SimonBrenninger/FT4232H-Debugger/debugger_base/debugger_base.kicad_pcb

## KiCad design debugger_base/debugger_base.kicad_pcb (2025-02-14)

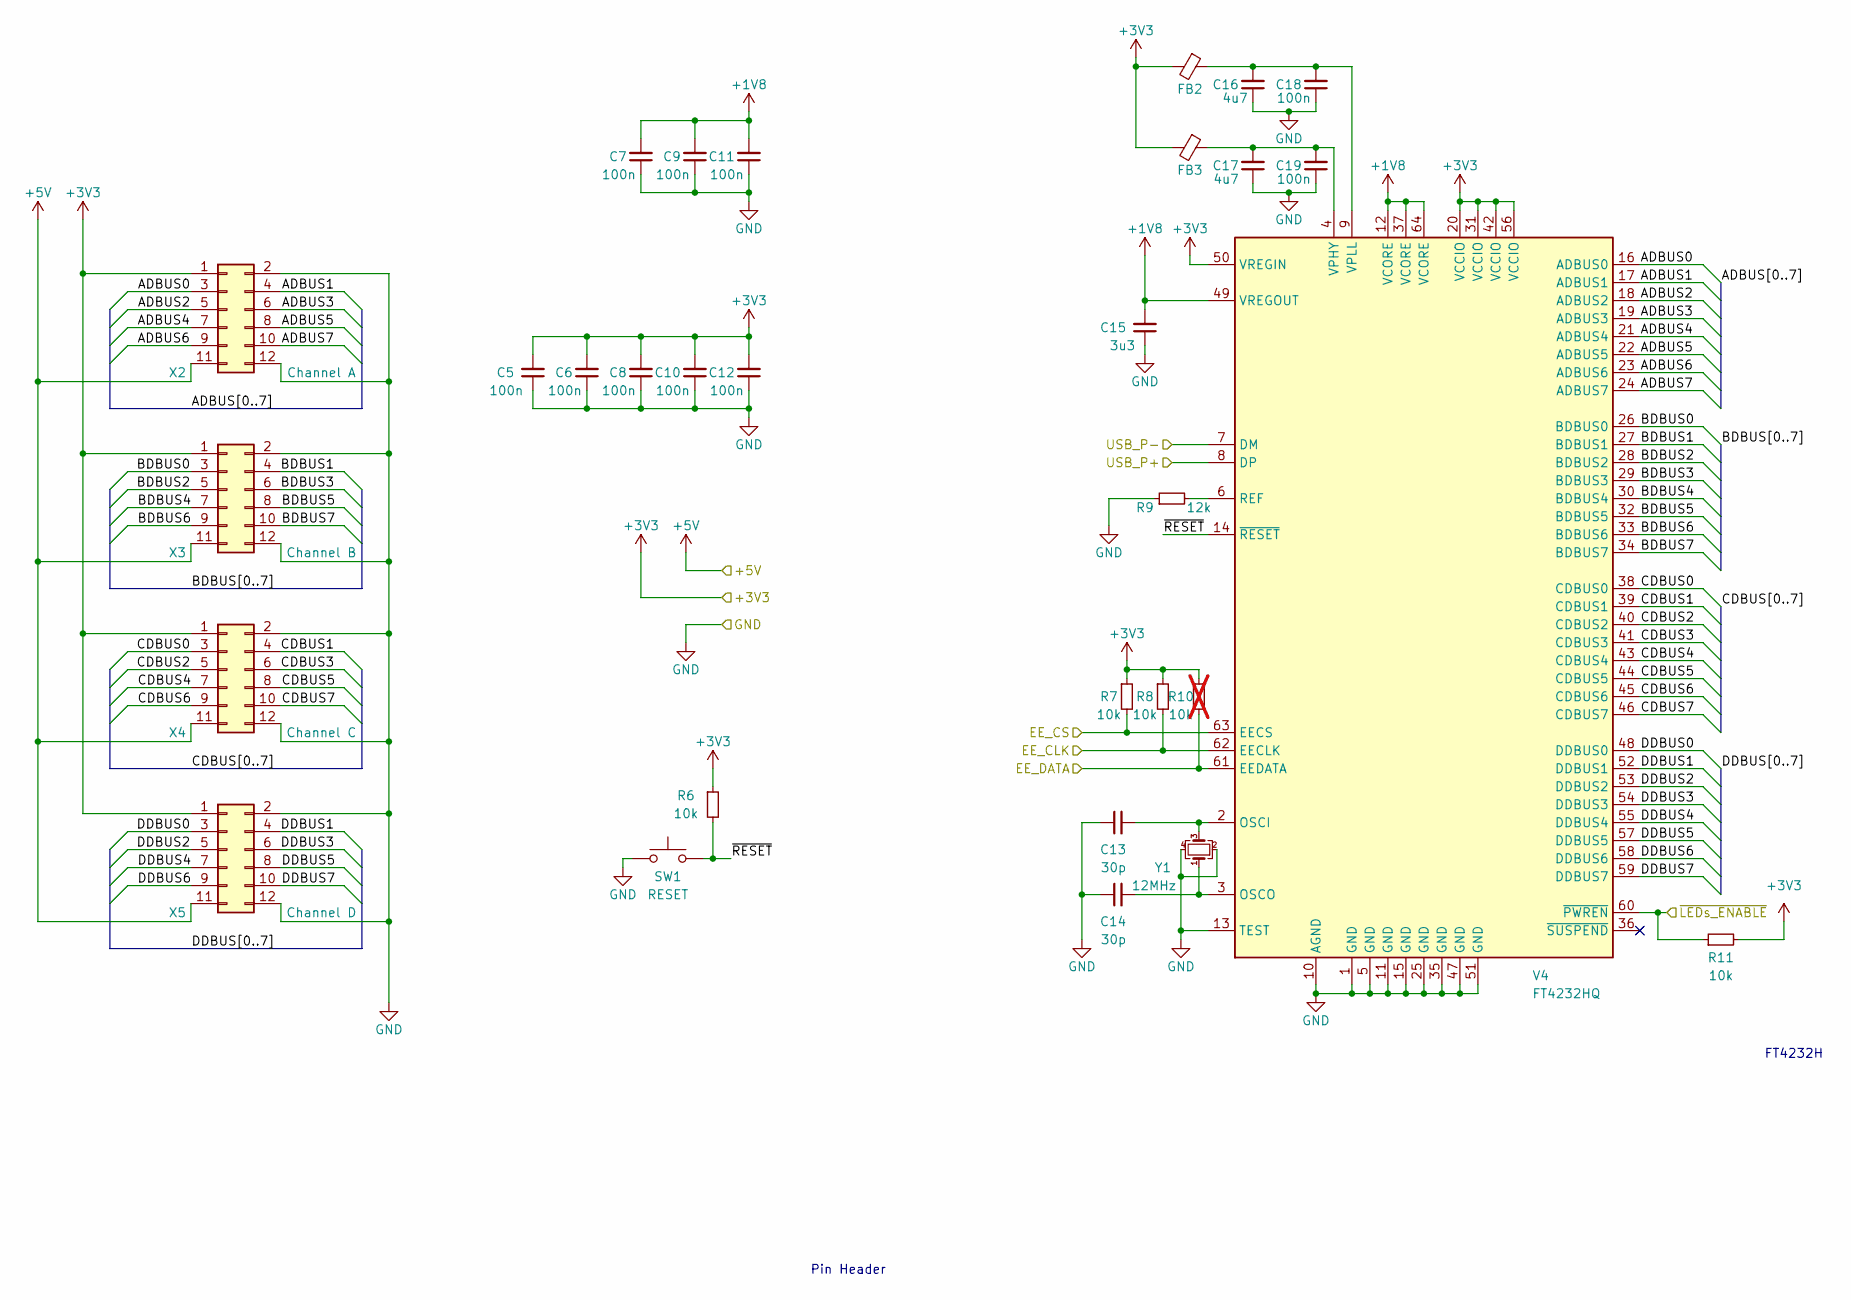
[picture p1: schematic debugger_base_ft4232h.kicad_sch, FT4232 Debugger Base]

Parts:
C5, C6, C7, C8, C9, C10, C11, C12, C18, C19: 100n; C_0402_1005Metric
C13, C14: 30p; C_0402_1005Metric
C15: 3u3; C_0402_1005Metric
C16, C17: 4u7; C_0402_1005Metric
FB2, FB3: FerriteBead_Small; L_0603_1608Metric
R6, R7, R8, R11: 10k; R_0402_1005Metric
R9: 12k; R_0402_1005Metric
R10: 10k; R_0402_1005Metric; not fitted
SW1: RESET; SW_SPST_EVQP2
V4: FT4232HQ; QFN-64-1EP_9x9mm_P0.5mm_EP4.35x4.35mm
X2: Channel A; header_female_02x06_613012243121
X3: Channel B; header_female_02x06_613012243121
X4: Channel C; header_female_02x06_613012243121
X5: Channel D; header_female_02x06_613012243121
Y1: 12MHz; Crystal_SMD_3225-4Pin_3.2x2.5mm

Connections:
+1V8: C7.2, C9.2, C11.2, C15.2, V4.12 (VCORE), V4.37 (VCORE), V4.49 (VREGOUT), V4.64 (VCORE)
+3V3: C5.2, C6.2, C8.2, C10.2, C12.2, FB2.2, FB3.2, R6.1, R7.1, R8.1, R10.1, R11.2, V4.20 (VCCIO), V4.31 (VCCIO), V4.42 (VCCIO), V4.50 (VREGIN), V4.56 (VCCIO), X2.1, X3.1, X4.1, X5.1; also elsewhere on the board
+5V: X2.11, X3.11, X4.11, X5.11; also elsewhere on the board
/FT4232H/ADBUS0: V4.16 (ADBUS0), X2.3
/FT4232H/ADBUS1: V4.17 (ADBUS1), X2.4
/FT4232H/ADBUS2: V4.18 (ADBUS2), X2.5
/FT4232H/ADBUS3: V4.19 (ADBUS3), X2.6
/FT4232H/ADBUS4: V4.21 (ADBUS4), X2.7
/FT4232H/ADBUS5: V4.22 (ADBUS5), X2.8
/FT4232H/ADBUS6: V4.23 (ADBUS6), X2.9
/FT4232H/ADBUS7: V4.24 (ADBUS7), X2.10
/FT4232H/BDBUS0: V4.26 (BDBUS0), X3.3
/FT4232H/BDBUS1: V4.27 (BDBUS1), X3.4
/FT4232H/BDBUS2: V4.28 (BDBUS2), X3.5
/FT4232H/BDBUS3: V4.29 (BDBUS3), X3.6
/FT4232H/BDBUS4: V4.30 (BDBUS4), X3.7
/FT4232H/BDBUS5: V4.32 (BDBUS5), X3.8
/FT4232H/BDBUS6: V4.33 (BDBUS6), X3.9
/FT4232H/BDBUS7: V4.34 (BDBUS7), X3.10
/FT4232H/CDBUS0: V4.38 (CDBUS0), X4.3
/FT4232H/CDBUS1: V4.39 (CDBUS1), X4.4
/FT4232H/CDBUS2: V4.40 (CDBUS2), X4.5
/FT4232H/CDBUS3: V4.41 (CDBUS3), X4.6
/FT4232H/CDBUS4: V4.43 (CDBUS4), X4.7
/FT4232H/CDBUS5: V4.44 (CDBUS5), X4.8
/FT4232H/CDBUS6: V4.45 (CDBUS6), X4.9
/FT4232H/CDBUS7: V4.46 (CDBUS7), X4.10
/FT4232H/DDBUS0: V4.48 (DDBUS0), X5.3
/FT4232H/DDBUS1: V4.52 (DDBUS1), X5.4
/FT4232H/DDBUS2: V4.53 (DDBUS2), X5.5
/FT4232H/DDBUS3: V4.54 (DDBUS3), X5.6
/FT4232H/DDBUS4: V4.55 (DDBUS4), X5.7
/FT4232H/DDBUS5: V4.57 (DDBUS5), X5.8
/FT4232H/DDBUS6: V4.58 (DDBUS6), X5.9
/FT4232H/DDBUS7: V4.59 (DDBUS7), X5.10
/FT4232H/EE_CLK: R8.2, V4.62 (EECLK); also elsewhere on the board
/FT4232H/EE_CS: R7.2, V4.63 (EECS); also elsewhere on the board
/FT4232H/EE_DATA: R10.2, V4.61 (EEDATA); also elsewhere on the board
/FT4232H/USB_P+: V4.8 (DP); also elsewhere on the board
/FT4232H/USB_P-: V4.7 (DM); also elsewhere on the board
/FT4232H/~LEDs_ENABLE: R11.1, V4.60 (~PWREN); also elsewhere on the board
/FT4232H/~RESET: R6.2, SW1.2, V4.14 (~RESET)
GND: C5.1, C6.1, C7.1, C8.1, C9.1, C10.1, C11.1, C12.1, C13.1, C14.1, C15.1, C16.1, C17.1, C18.1, C19.1, R9.1, SW1.1, V4.1 (GND), V4.5 (GND), V4.10 (AGND), V4.11 (GND), V4.13 (TEST), V4.15 (GND), V4.25 (GND), V4.35 (GND), V4.47 (GND), V4.51 (GND), X2.2, X2.12, X3.2, X3.12, X4.2, X4.12, X5.2, X5.12, Y1.2, Y1.4; also elsewhere on the board
unnamed: C13.2, V4.2 (OSCI), Y1.3
unnamed: C14.2, V4.3 (OSCO), Y1.1
unnamed: R9.2, V4.6 (REF)
unnamed: C17.2, C19.2, FB3.1, V4.4 (VPHY)
unnamed: C16.2, C18.2, FB2.1, V4.9 (VPLL)

Notes on the sheet:
FT4232H
Pin Header

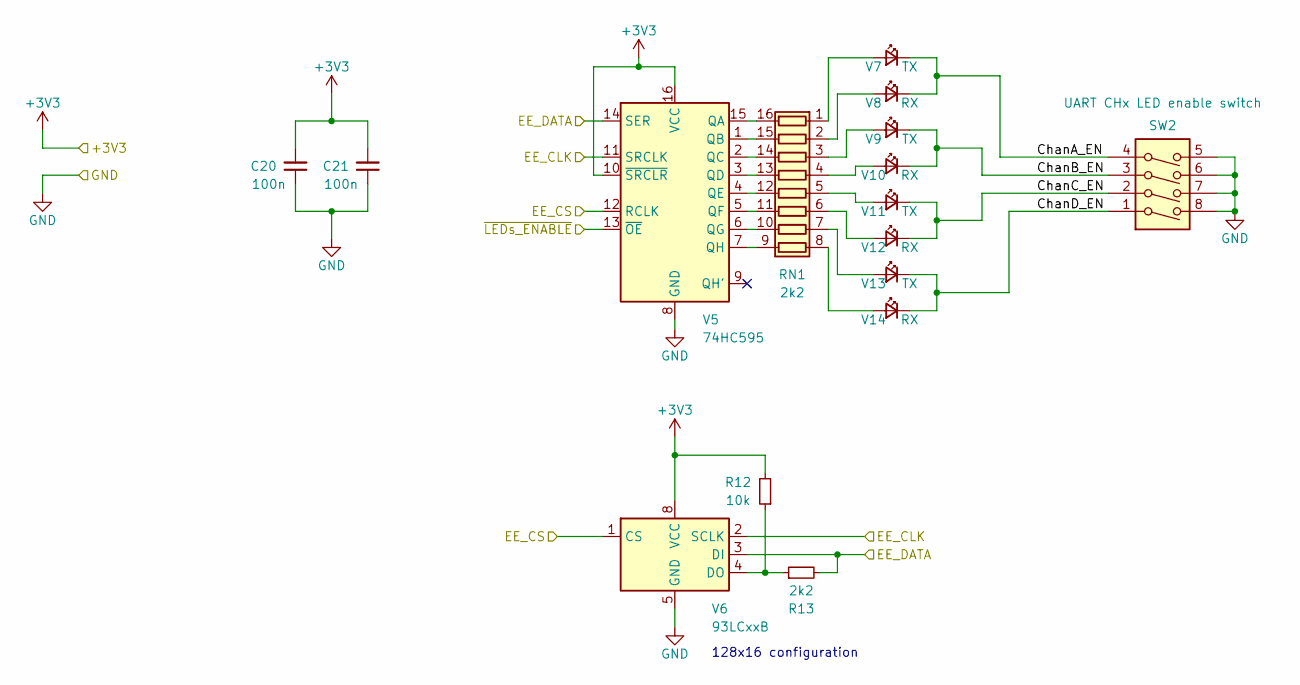
[picture p2: schematic debugger_base_uart_leds.kicad_sch, FT4232 Debugger Base]

Parts:
C20, C21: 100n; C_0402_1005Metric
R12: 10k; R_0402_1005Metric
R13: 2k2; R_0402_1005Metric
RN1: 2k2; R_Array_Convex_8x0602
SW2: UART CHx LED enable switch; SW_DIP_SPSTx04_Slide_6.7x11.72mm_W8.61mm_P2.54mm_LowProfile
V5: 74HC595
V6: 93LCxxB; DFN-8-1EP_3x2mm_P0.5mm_EP1.7x1.4mm
V7, V9, V11, V13: TX; LED_0603_1608Metric
V8, V10, V12, V14: RX; LED_0603_1608Metric

Connections:
+3V3: C20.2, C21.2, R12.2, V5.10 (~SRCLR), V5.16 (VCC), V6.8 (VCC); also elsewhere on the board
/FT4232H/EE_CLK: V5.11 (SRCLK), V6.2 (SCLK); also elsewhere on the board
/FT4232H/EE_CS: V5.12 (RCLK), V6.1 (CS); also elsewhere on the board
/FT4232H/EE_DATA: R13.2, V5.14 (SER), V6.3 (DI); also elsewhere on the board
/FT4232H/~LEDs_ENABLE: V5.13 (~OE); also elsewhere on the board
/LEDs, EEPROM/ChanA_EN: SW2.4, V7.1 (K), V8.1 (K)
/LEDs, EEPROM/ChanB_EN: SW2.3, V9.1 (K), V10.1 (K)
/LEDs, EEPROM/ChanC_EN: SW2.2, V11.1 (K), V12.1 (K)
/LEDs, EEPROM/ChanD_EN: SW2.1, V13.1 (K), V14.1 (K)
GND: C20.1, C21.1, SW2.5, SW2.6, SW2.7, SW2.8, V5.8 (GND), V6.5 (GND); also elsewhere on the board
unnamed: RN1.1 (R1.1), V7.2 (A)
unnamed: RN1.16 (R1.2), V5.15 (QA)
unnamed: RN1.2 (R2.1), V8.2 (A)
unnamed: RN1.15 (R2.2), V5.1 (QB)
unnamed: RN1.3 (R3.1), V9.2 (A)
unnamed: RN1.14 (R3.2), V5.2 (QC)
unnamed: RN1.4 (R4.1), V10.2 (A)
unnamed: RN1.13 (R4.2), V5.3 (QD)
unnamed: RN1.5 (R5.1), V11.2 (A)
unnamed: RN1.12 (R5.2), V5.4 (QE)
unnamed: RN1.6 (R6.1), V12.2 (A)
unnamed: RN1.11 (R6.2), V5.5 (QF)
unnamed: RN1.7 (R7.1), V13.2 (A)
unnamed: RN1.10 (R7.2), V5.6 (QG)
unnamed: RN1.8 (R8.1), V14.2 (A)
unnamed: RN1.9 (R8.2), V5.7 (QH)
unnamed: R12.1, R13.1, V6.4 (DO)

Notes on the sheet:
128x16 configuration

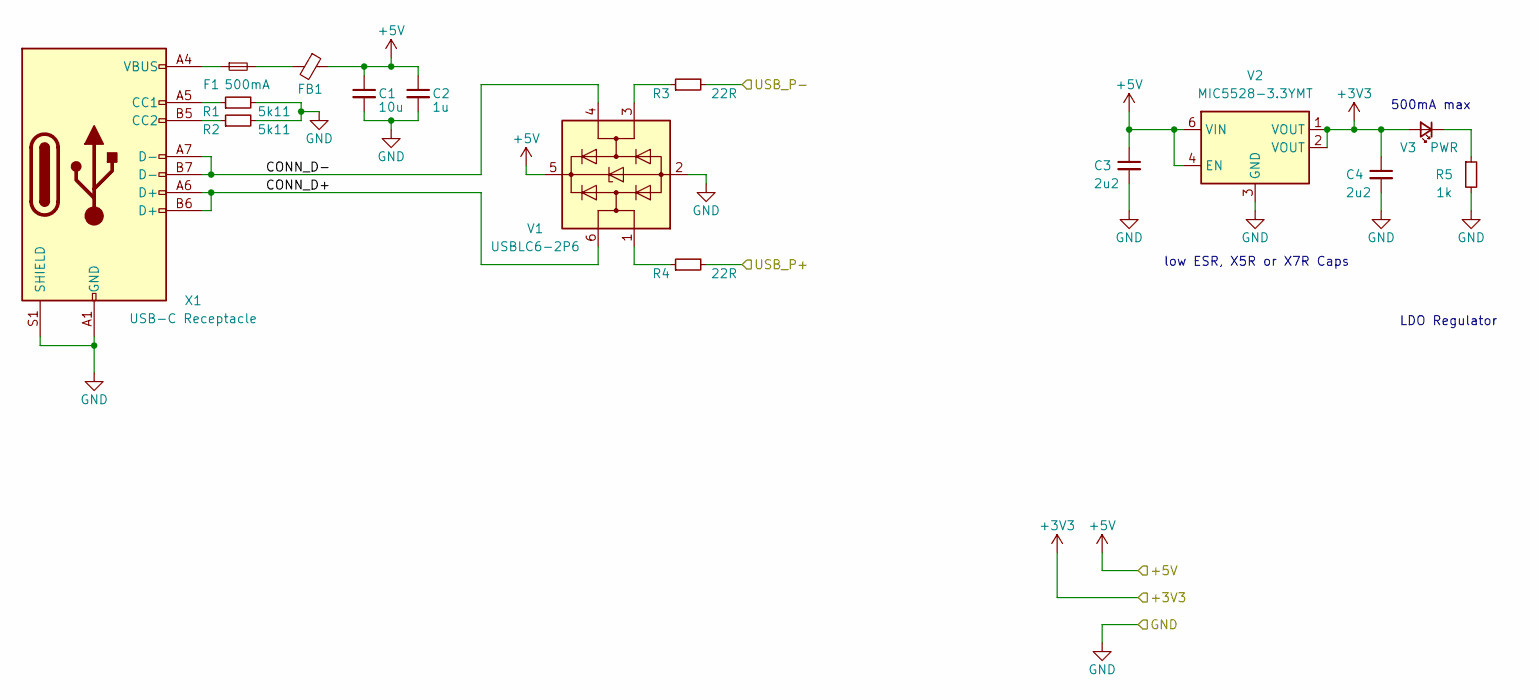
[picture p3: schematic debugger_base_power.kicad_sch, FT4232 Debugger Base]

Parts:
C1: 10u; C_0402_1005Metric
C2: 1u; C_0402_1005Metric
C3, C4: 2u2; C_0402_1005Metric
F1: 500mA; Fuse_0805_2012Metric
FB1: FerriteBead_Small; L_0603_1608Metric
R1, R2: 5k11; R_0402_1005Metric
R3, R4: 22R; R_0402_1005Metric
R5: 1k; R_0402_1005Metric
V1: USBLC6-2P6; SOT-666
V2: MIC5528-3.3YMT; DFN-6-1EP_1.2x1.2mm_P0.4mm_EP0.3x0.94mm_PullBack
V3: PWR; LED_0603_1608Metric
X1: USB-C Receptacle; USB_C_Receptacle_G-Switch_GT-USB-7010ASV

Connections:
+3V3: C4.1, V2.1 (VOUT), V2.2 (VOUT), V3.2 (A); also elsewhere on the board
+5V: C1.1, C2.1, C3.1, FB1.1, V1.5 (VBUS), V2.4 (EN), V2.6 (VIN); also elsewhere on the board
/FT4232H/USB_P+: R4.2; also elsewhere on the board
/FT4232H/USB_P-: R3.2; also elsewhere on the board
/Power/CONN_D+: V1.6 (I/O1), X1.A6 (D+), X1.B6 (D+)
/Power/CONN_D-: V1.4 (I/O2), X1.A7 (D-), X1.B7 (D-)
GND: C1.2, C2.2, C3.2, C4.2, R1.2, R2.2, R5.2, V1.2 (GND), V2.3 (GND), V2.7 (GND), X1.A1 (GND), X1.A12 (GND), X1.B1 (GND), X1.B12 (GND), X1.S1 (SHIELD); also elsewhere on the board
unnamed: F1.1, X1.A4 (VBUS), X1.A9 (VBUS), X1.B4 (VBUS), X1.B9 (VBUS)
unnamed: F1.2, FB1.2
unnamed: R3.1, V1.3 (I/O2)
unnamed: R4.1, V1.1 (I/O1)
unnamed: R5.1, V3.1 (K)
unnamed: R1.1, X1.A5 (CC1)
unnamed: R2.1, X1.B5 (CC2)

Notes on the sheet:
LDO Regulator
low ESR, X5R or X7R Caps
500mA max

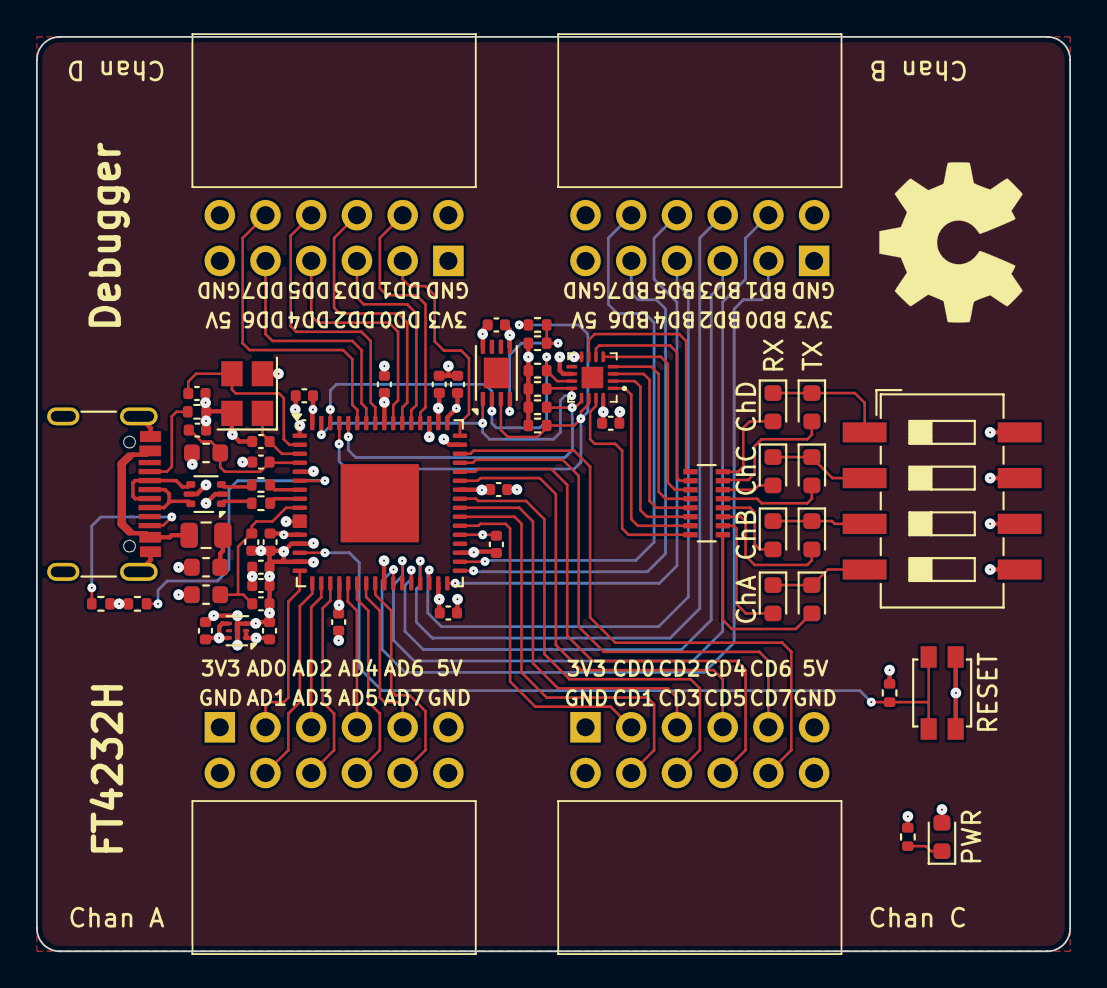
[picture p4: board debugger_base.kicad_pcb from above]

Board: 4 copper layers, 57.4 x 50.8 mm, 61 parts (0 on the bottom side), 78 nets.
