SimonBrenninger/FT4232H-Debugger/debugger_adapter/debugger_adapter.kicad_pcb

## KiCad design debugger_adapter/debugger_adapter.kicad_pcb (2025-02-14)

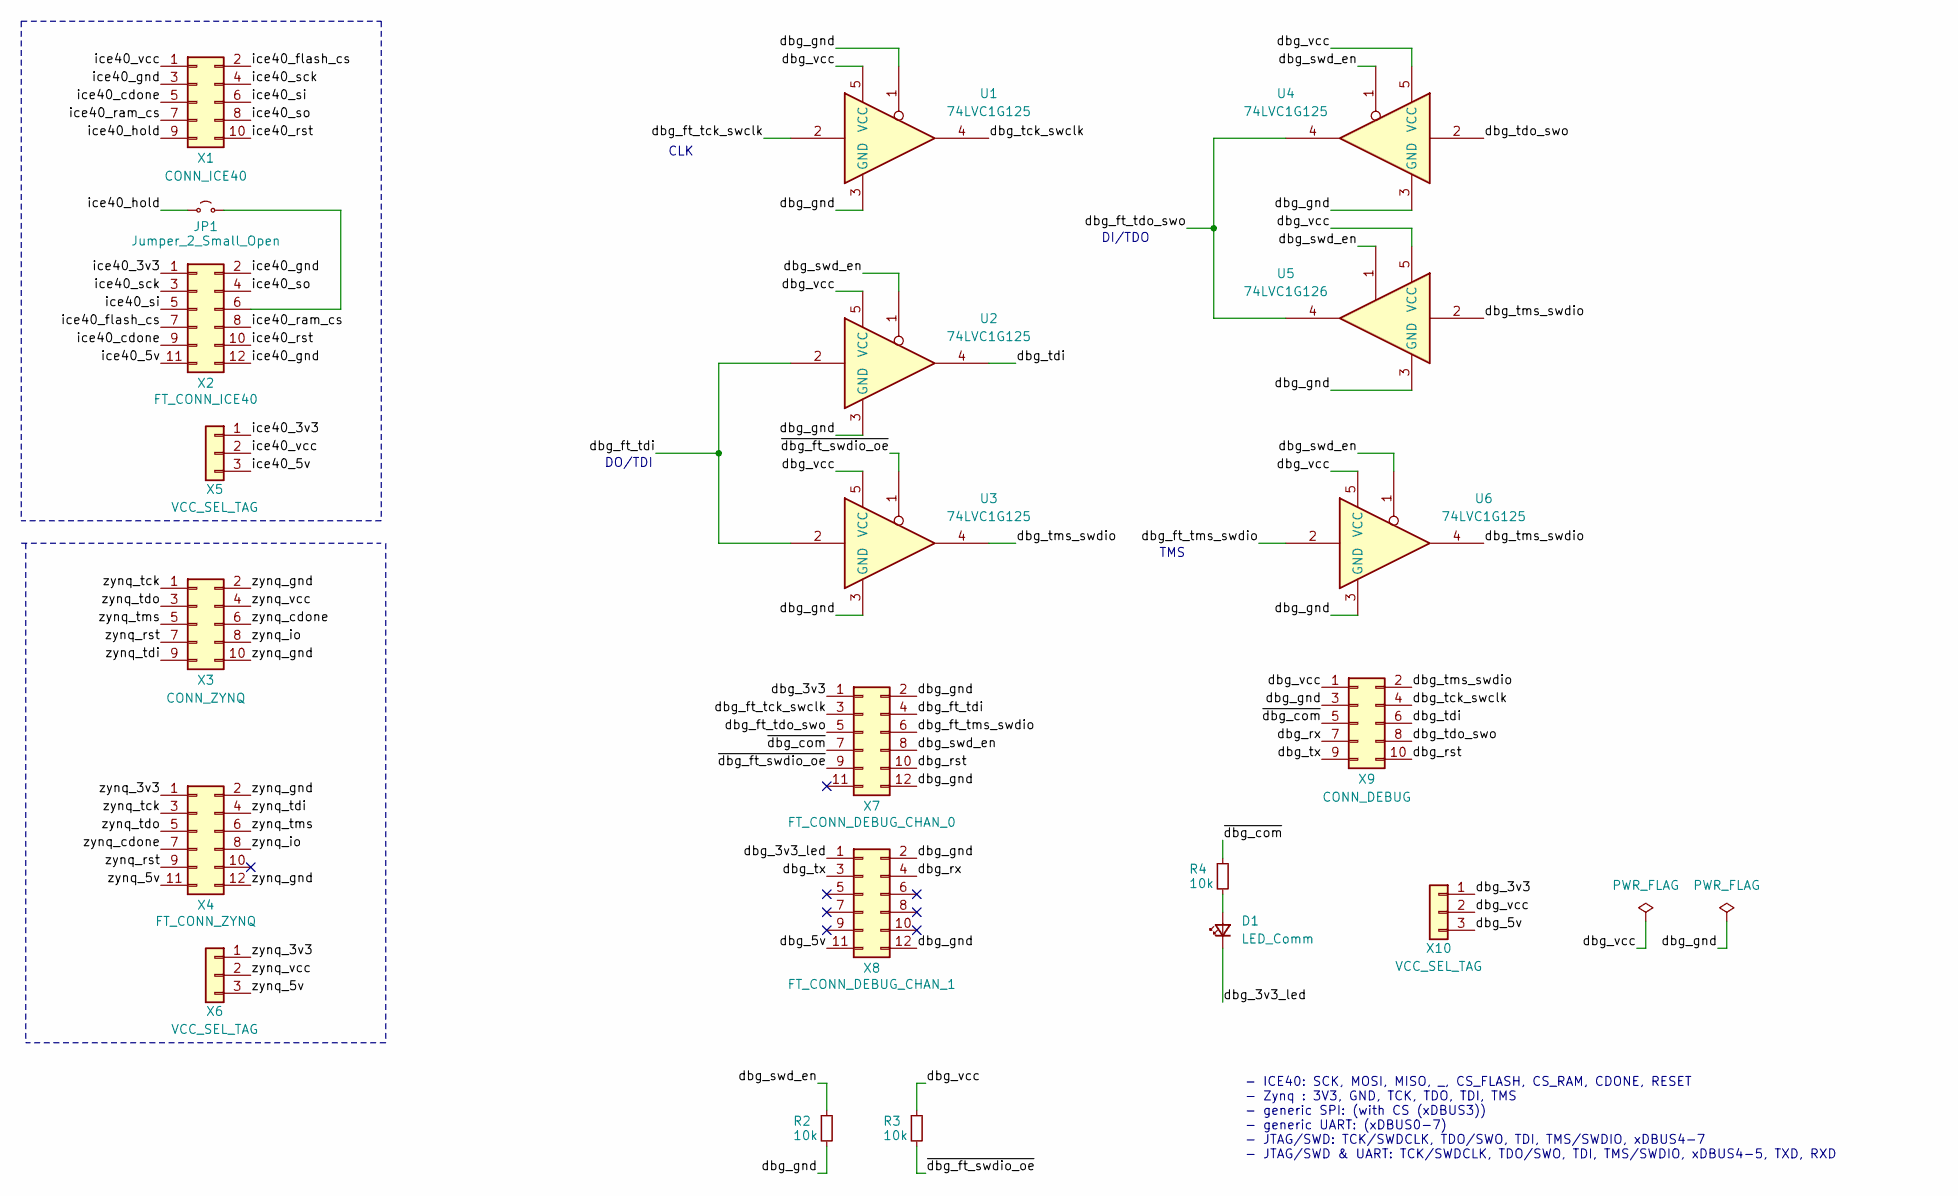
[picture p5: schematic debugger_adapter.kicad_sch, FT4232 Debugger Adapter]

Parts:
D1: LED_Comm; LED_0603_1608Metric
JP1: Jumper_2_Small_Open; PinHeader_1x02_P2.54mm_Vertical
R2, R3, R4: 10k; R_0402_1005Metric
U1, U2, U3, U4, U6: 74LVC1G125; SOT-353_SC-70-5
U5: 74LVC1G126; SOT-353_SC-70-5
X1: CONN_ICE40; IDC-Header_2x05_P2.54mm_Vertical
X2: FT_CONN_ICE40; header_male_02x06_HDRRA12W67P254_2X6_1524X254X503P
X3: CONN_ZYNQ; IDC-Header_2x05_P2.54mm_Vertical
X4: FT_CONN_ZYNQ; header_male_02x06_HDRRA12W67P254_2X6_1524X254X503P
X5, X6, X10: VCC_SEL_TAG; PinHeader_1x03_P2.54mm_Vertical
X7: FT_CONN_DEBUG_CHAN_0; header_male_02x06_HDRRA12W67P254_2X6_1524X254X503P
X8: FT_CONN_DEBUG_CHAN_1; header_male_02x06_HDRRA12W67P254_2X6_1524X254X503P
X9: CONN_DEBUG; IDC-Header_2x05_P2.54mm_Vertical

Connections:
/dbg_3v3: X7.1, X10.1
/dbg_3v3_led: D1.1 (K), X8.1
/dbg_5v: X8.11, X10.3
/dbg_ft_tck_swclk: U1.2, X7.3
/dbg_ft_tdi: U2.2, U3.2, X7.4
/dbg_ft_tdo_swo: U4.4, U5.4, X7.5
/dbg_ft_tms_swdio: U6.2, X7.6
/dbg_gnd: R2.2, U1.1, U1.3 (GND), U2.3 (GND), U3.3 (GND), U4.3 (GND), U5.3 (GND), U6.3 (GND), X7.2, X7.12, X8.2, X8.12, X9.3
/dbg_rst: X7.10, X9.10
/dbg_rx: X8.4, X9.7
/dbg_swd_en: R2.1, U2.1, U4.1, U5.1, U6.1, X7.8
/dbg_tck_swclk: U1.4, X9.4
/dbg_tdi: U2.4, X9.6
/dbg_tdo_swo: U4.2, X9.8
/dbg_tms_swdio: U3.4, U5.2, U6.4, X9.2
/dbg_tx: X8.3, X9.9
/dbg_vcc: R3.1, U1.5 (VCC), U2.5 (VCC), U3.5 (VCC), U4.5 (VCC), U5.5 (VCC), U6.5 (VCC), X9.1, X10.2
/ice40_3v3: X2.1, X5.1
/ice40_5v: X2.11, X5.3
/ice40_cdone: X1.5, X2.9
/ice40_flash_cs: X1.2, X2.7
/ice40_gnd: X1.3, X2.2, X2.12
/ice40_hold: JP1.1 (A), X1.9
/ice40_ram_cs: X1.7, X2.8
/ice40_rst: X1.10, X2.10
/ice40_sck: X1.4, X2.3
/ice40_si: X1.6, X2.5
/ice40_so: X1.8, X2.4
/ice40_vcc: X1.1, X5.2
/zynq_3v3: X4.1, X6.1
/zynq_5v: X4.11, X6.3
/zynq_cdone: X3.6, X4.7
/zynq_gnd: X3.2, X3.10, X4.2, X4.12
/zynq_io: X3.8, X4.8
/zynq_rst: X3.7, X4.9
/zynq_tck: X3.1, X4.3
/zynq_tdi: X3.9, X4.4
/zynq_tdo: X3.3, X4.5
/zynq_tms: X3.5, X4.6
/zynq_vcc: X3.4, X6.2
/~dbg_com: R4.1, X7.7, X9.5
/~dbg_ft_swdio_oe: R3.2, U3.1, X7.9
unnamed: D1.2 (A), R4.2
unnamed: JP1.2 (B), X2.6

Notes on the sheet:
CLK
- ICE40: SCK, MOSI, MISO, _, CS_FLASH, CS_RAM, CDONE, RESET - Zynq : 3V3, GND, TCK, TDO, TDI, TMS - generic SPI: (with CS (xDBUS3)) - generic UART: (xDBUS0-7) - JTAG/SWD: TCK/SWDCLK, TDO/SWO, TDI, TMS/SWDIO, xDBUS4-7 - JTAG/SWD & UART: TCK/SWDCLK, TDO/SWO, TDI, TMS/SWDIO, xDBUS4-5, TXD, RXD
DO/TDI
TMS
DI/TDO

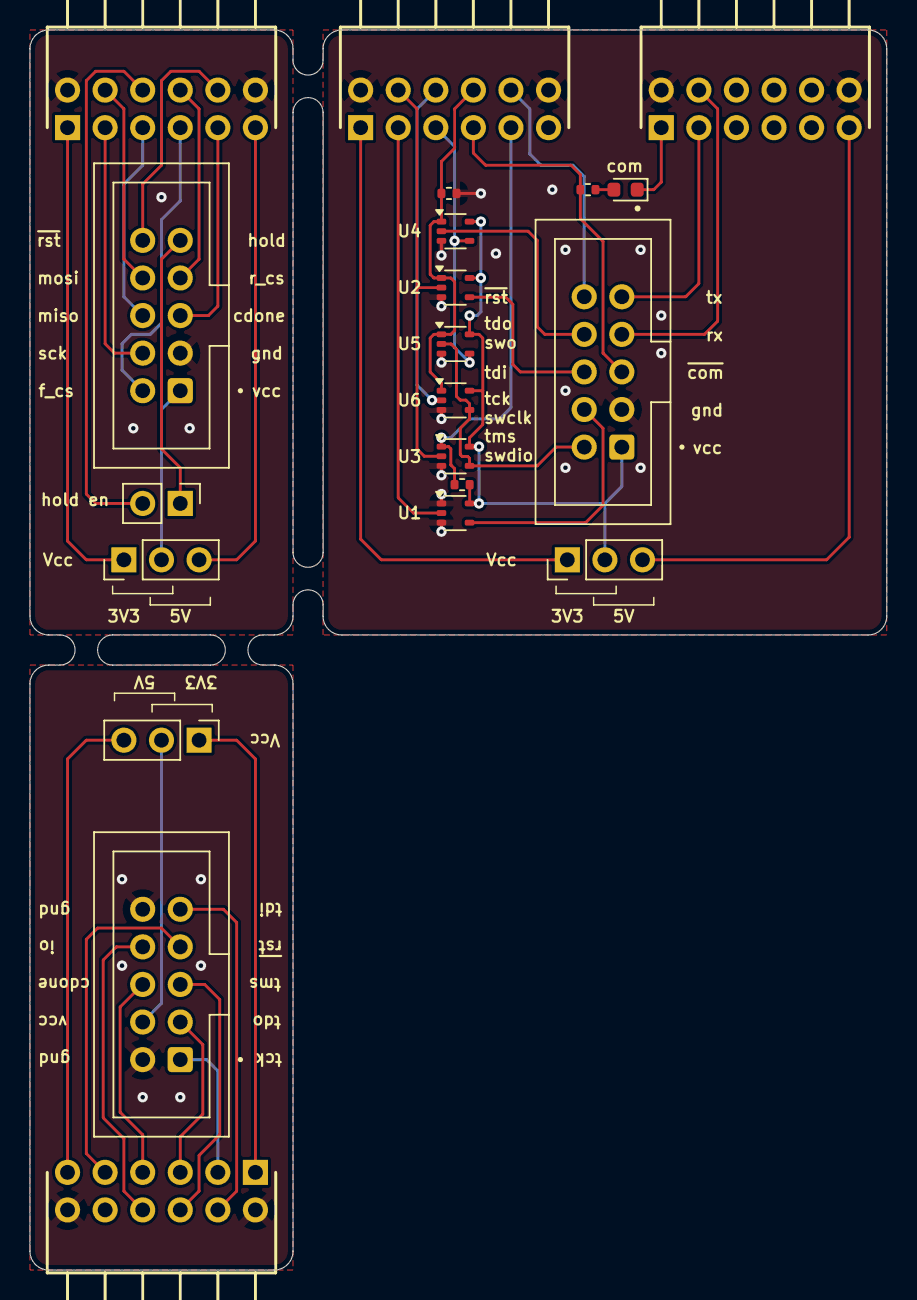
[picture p6: board debugger_adapter.kicad_pcb from above]

Board: 2 copper layers, 57.9 x 83.8 mm, 21 parts (0 on the bottom side), 44 nets.
