SimonBrenninger/FT4232H-Debugger/(commit log)

2024-02-11 add rx/tx status leds
    [debugger_base.kicad_sch]
2024-02-21 exclude traffic leds from base board
    [debugger_base.kicad_sch]
2024-03-16 add led dip-switches; create pcb
    [debugger_base.kicad_pcb, debugger_base.kicad_sch]
2024-04-20 finish base board pcb
    [debugger_base.csv, debugger_base.kicad_pcb, debugger_base.kicad_sch, debugger_base.ods, debugger_base_ft4232h.kicad_sch, debugger_base_power.kicad_sch, debugger_base_uart_leds.kicad_sch]
2024-04-20 add adapter boards kicad project
    [EDI2CAP.CFG, SMH-105-02-F-D.stp, SMH-105-02-T-D-TR.SchLib, SMH10502TDTR.PcbLib, chips.prt, debugger_adapter.kicad_pcb, debugger_adapter.kicad_sch, smh10502tdtr.psm]
2024-04-20 fix wrong silkscreen pinout
    [debugger_adapter.kicad_pcb, debugger_adapter.kicad_sch, debugger_base.kicad_pcb]
2024-06-02 add version number to silkscreen
    [debugger_base.kicad_pcb]
2025-02-13 add design date
    [debugger_base.kicad_pcb, debugger_base.kicad_sch, debugger_base_ft4232h.kicad_sch, debugger_base_power.kicad_sch, debugger_base_uart_leds.kicad_sch]
2025-02-14 remove unused footprint and 3d models
    [EDI2CAP.CFG, SMH-105-02-F-D.stp, SMH-105-02-T-D-TR.SchLib, SMH10502TDTR.PcbLib, chips.prt, smh10502tdtr.psm]
2025-02-14 decrease clearance of copper pours
    [debugger_adapter.kicad_pcb, debugger_adapter.kicad_sch, debugger_base.kicad_pcb, debugger_base.kicad_sch, debugger_base_ft4232h.kicad_sch, debugger_base_power.kicad_sch, debugger_base_uart_leds.kicad_sch]
